arthurpaulhs/Luminocity/Schematics/luci2_device-master/luci2_device_bom.xlsx

No | Component | Unit | Unit Price | Component Price | Reference
1 | AK300/2 | 3 | 0.1 | 0.3 | link (https://www.tokopedia.com/audioparts/terminal-block-2p-2-pin-warna-biru-kf-301)
2 | AK300/4 | 1 | 0.2 | 0.2 | link (https://www.tokopedia.com/audioparts/terminal-block-2p-2-pin-warna-biru-kf-301)
3 | HEADER-1X2ROUND | 1 | 0.3 | 0.3 | link (https://www.tokopedia.com/goldendream/pin-header-254mm-male-40-pin-single-row-strip-silver-connector)
4 | HEADER-1X3ROUND
5 | HEADER-1X5ROUND
6 | TAC_SWITCHPTH | 1 | 0.1 | 0.1 | link (https://www.tokopedia.com/goldendream/tact-switch-6x6x43mm-saklar-kecil-micro-on-off-tactile-4-pin)
7 | 1N4004 | 1 | 0.1 | 0.1 | link (https://www.tokopedia.com/pielectronics/1n4004-rectifier-diode-dioda-m4-1a-400v)
8 | 2N3904-MMBT | 1 | 0.1 | 0.1 | link (http://www.aliexpress.com/item/100PCS-MMBT3904-SOT-23-2N3904-SMD-40V-200mA-NPN-Transistor/1852107626.html)
9 | ARDUINO_PRO_MICRO | 1 | 3.4 | 3.4 | link (http://www.aliexpress.com/item/Free-Shipping-5-pcs-Mini-Leonardo-Pro-Micro-ATmega32U4-5V-16MHz-Module-For-Arduino-Best-Quality/32269794147.html)
10 | LEDCHIPLED_0805 | 1 | 0.1 | 0.1 | JP
11 | DCDCMODULE_SMALL | 2 | 1.2 | 2.4 | link (https://www.tokopedia.com/goldendream/mini-lm2596-adjustable-dc-dc-step-down-module-in-45-28v-out-08-20v)
12 | ESP07-16PIN | 1 | 2.5 | 2.5 | link (http://www.aliexpress.com/item/ESP8266-serial-WIFI-model-ESP-07-Authenticity-Guaranteed/32220241193.html)
13 | HLK-PM01 | 1 | 4 | 4 | link (http://www.hlktech.net/product_detail.php?ProId=56)
14 | PMOSFET_PTO220BV | 1 | 1 | 1 | link (https://www.tokopedia.com/akhishop/irf-9540)
15 | R-EU_M0805 | 1 | 1 | 1 | JP
16 | R-EU_M0805
17 | R-EU_M0805
18 | R-EU_M0805
19 | R-EU_M0805
20 | LEDCHIPLED_0805 | 1 | 0.1 | 0.1 | JP
21 | XBEE-PRO | 1 | 17.5 | 17.5 | link (http://www.digikey.com/product-detail/en/XB24CZ7SIT-004/602-1558-ND/5322372?WT.z_cid=ref_neda_dkc_buynow)
22 | XBEE-HEADER | 2 | 0.5 | 1 | link (https://www.tokopedia.com/sadewa-elc/female-header-2mm-20mm-1x40-socket-xbee)
23 | XBEE-ANTENNA | 1 | 2.5 | 2.5 | link (http://www.aliexpress.com/item/5-piece-lot-2-4-GHz-5dBi-802-11b-g-WiFi-Antenna-Aerial-RP-SMA-Male/32602509915.html)
24 | WIFI-ANTENNA | 1 | 1.1 | 1.1 | link (http://www.aliexpress.com/item/Hot-Sale-Smart-Electronics-1set-ESP-8266-ESP8266-Serial-WIFI-Wireless-Transceiver-Module-MT7681-3DBI-Gain/32443768782.html)
25 | ARDUINO-HEADER | 1 | 0.5 | 0.5 | JP
Jumlah |  |  |  | 38.2
Smallest unit price is USD 0,1
Currency in USD
