arthurpaulhs/Luminocity/Schematics/luci2_device-master/luci2_device_revA.brd

## EAGLE design Schematics/luci2_device-master/luci2_device_revA.brd (2016-07-13, an earlier design)

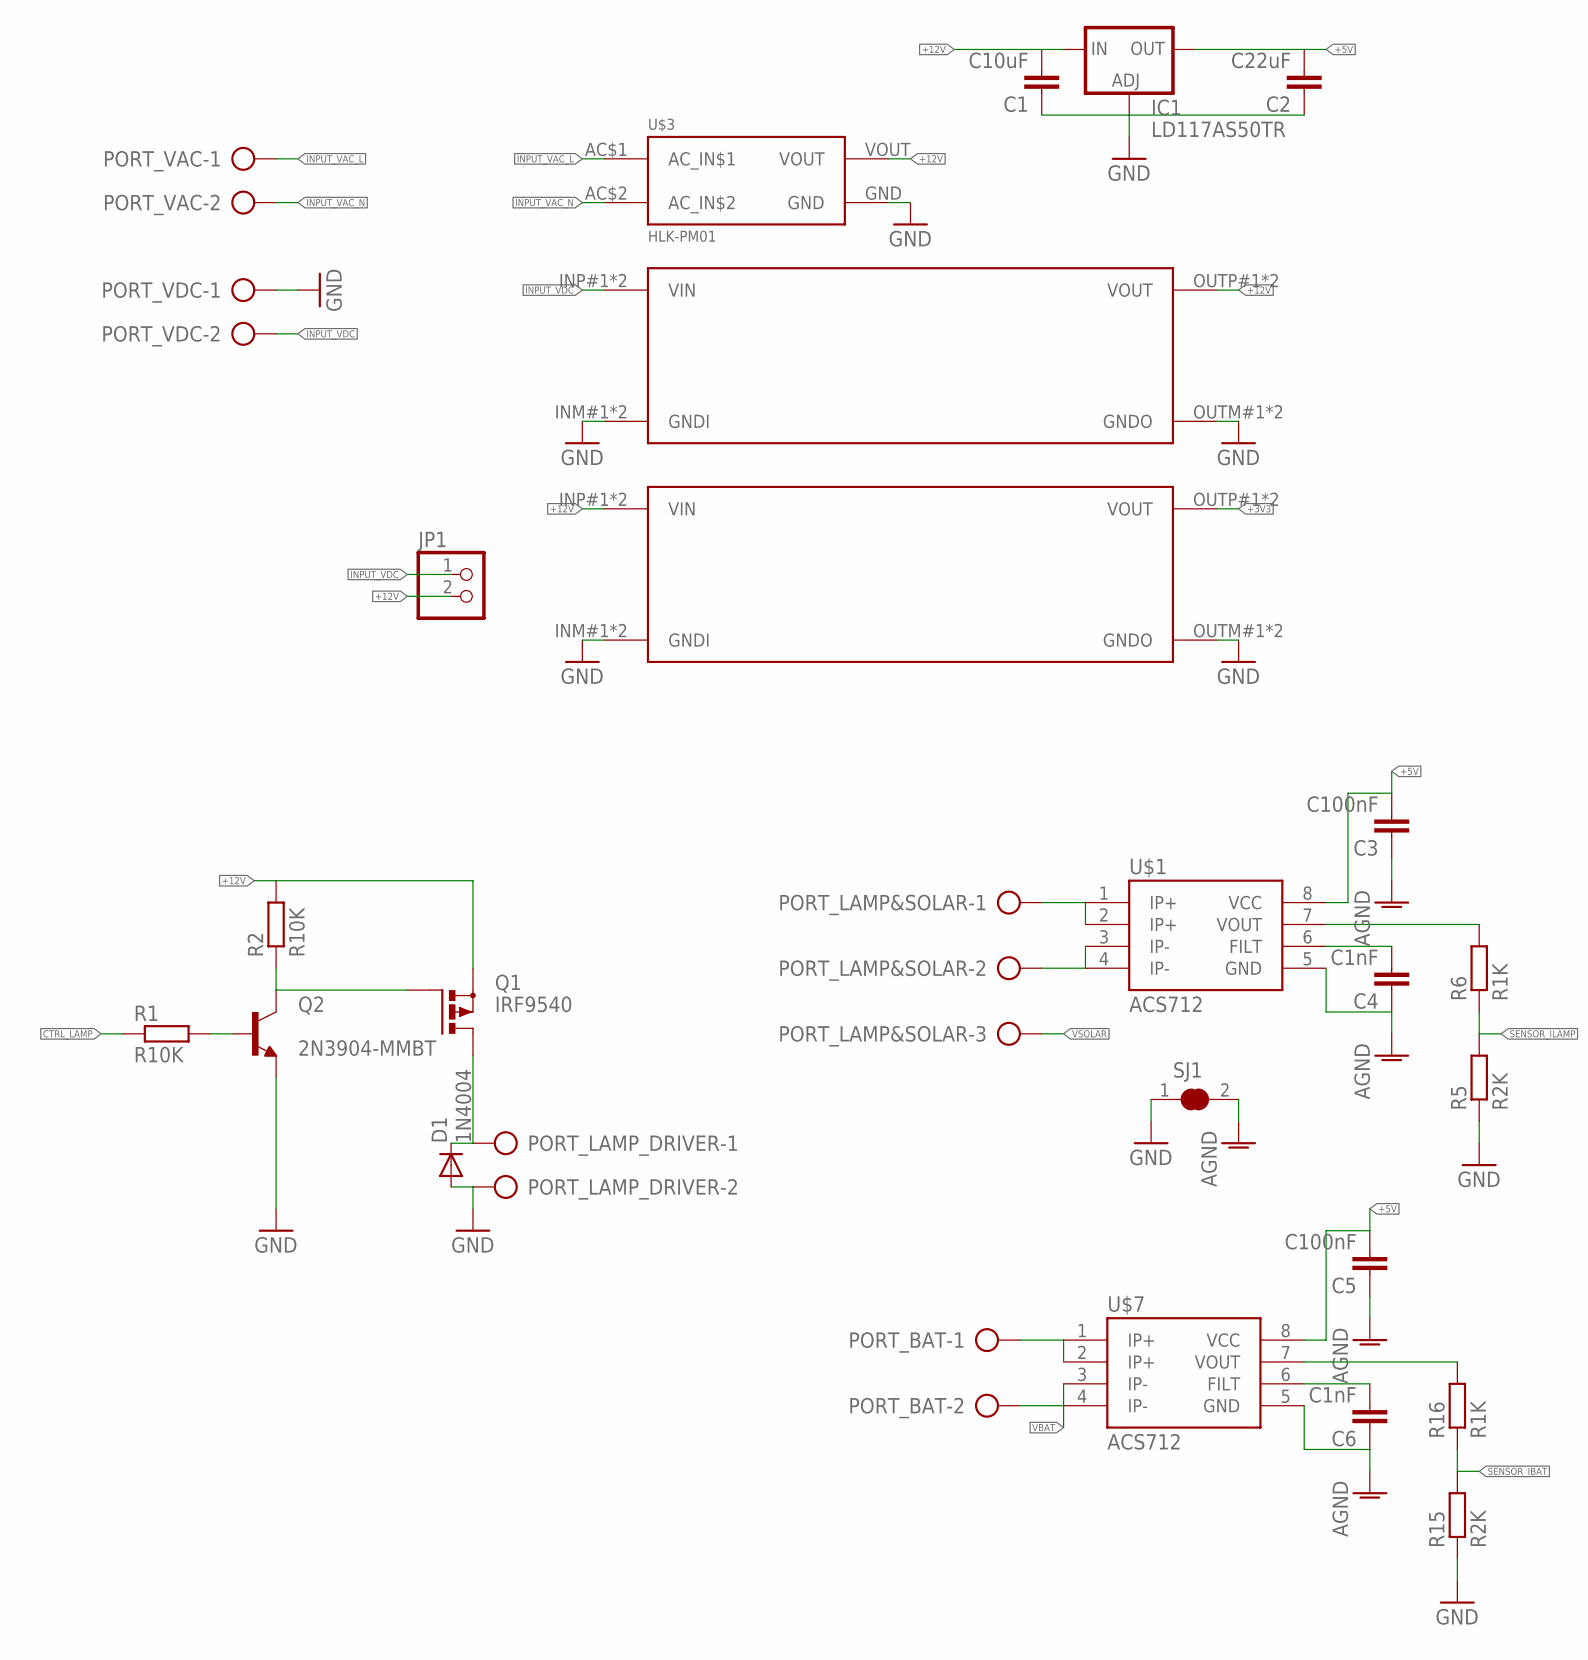
[picture p1: schematic luci2_device_revA.sch, part in row 1, column 1]

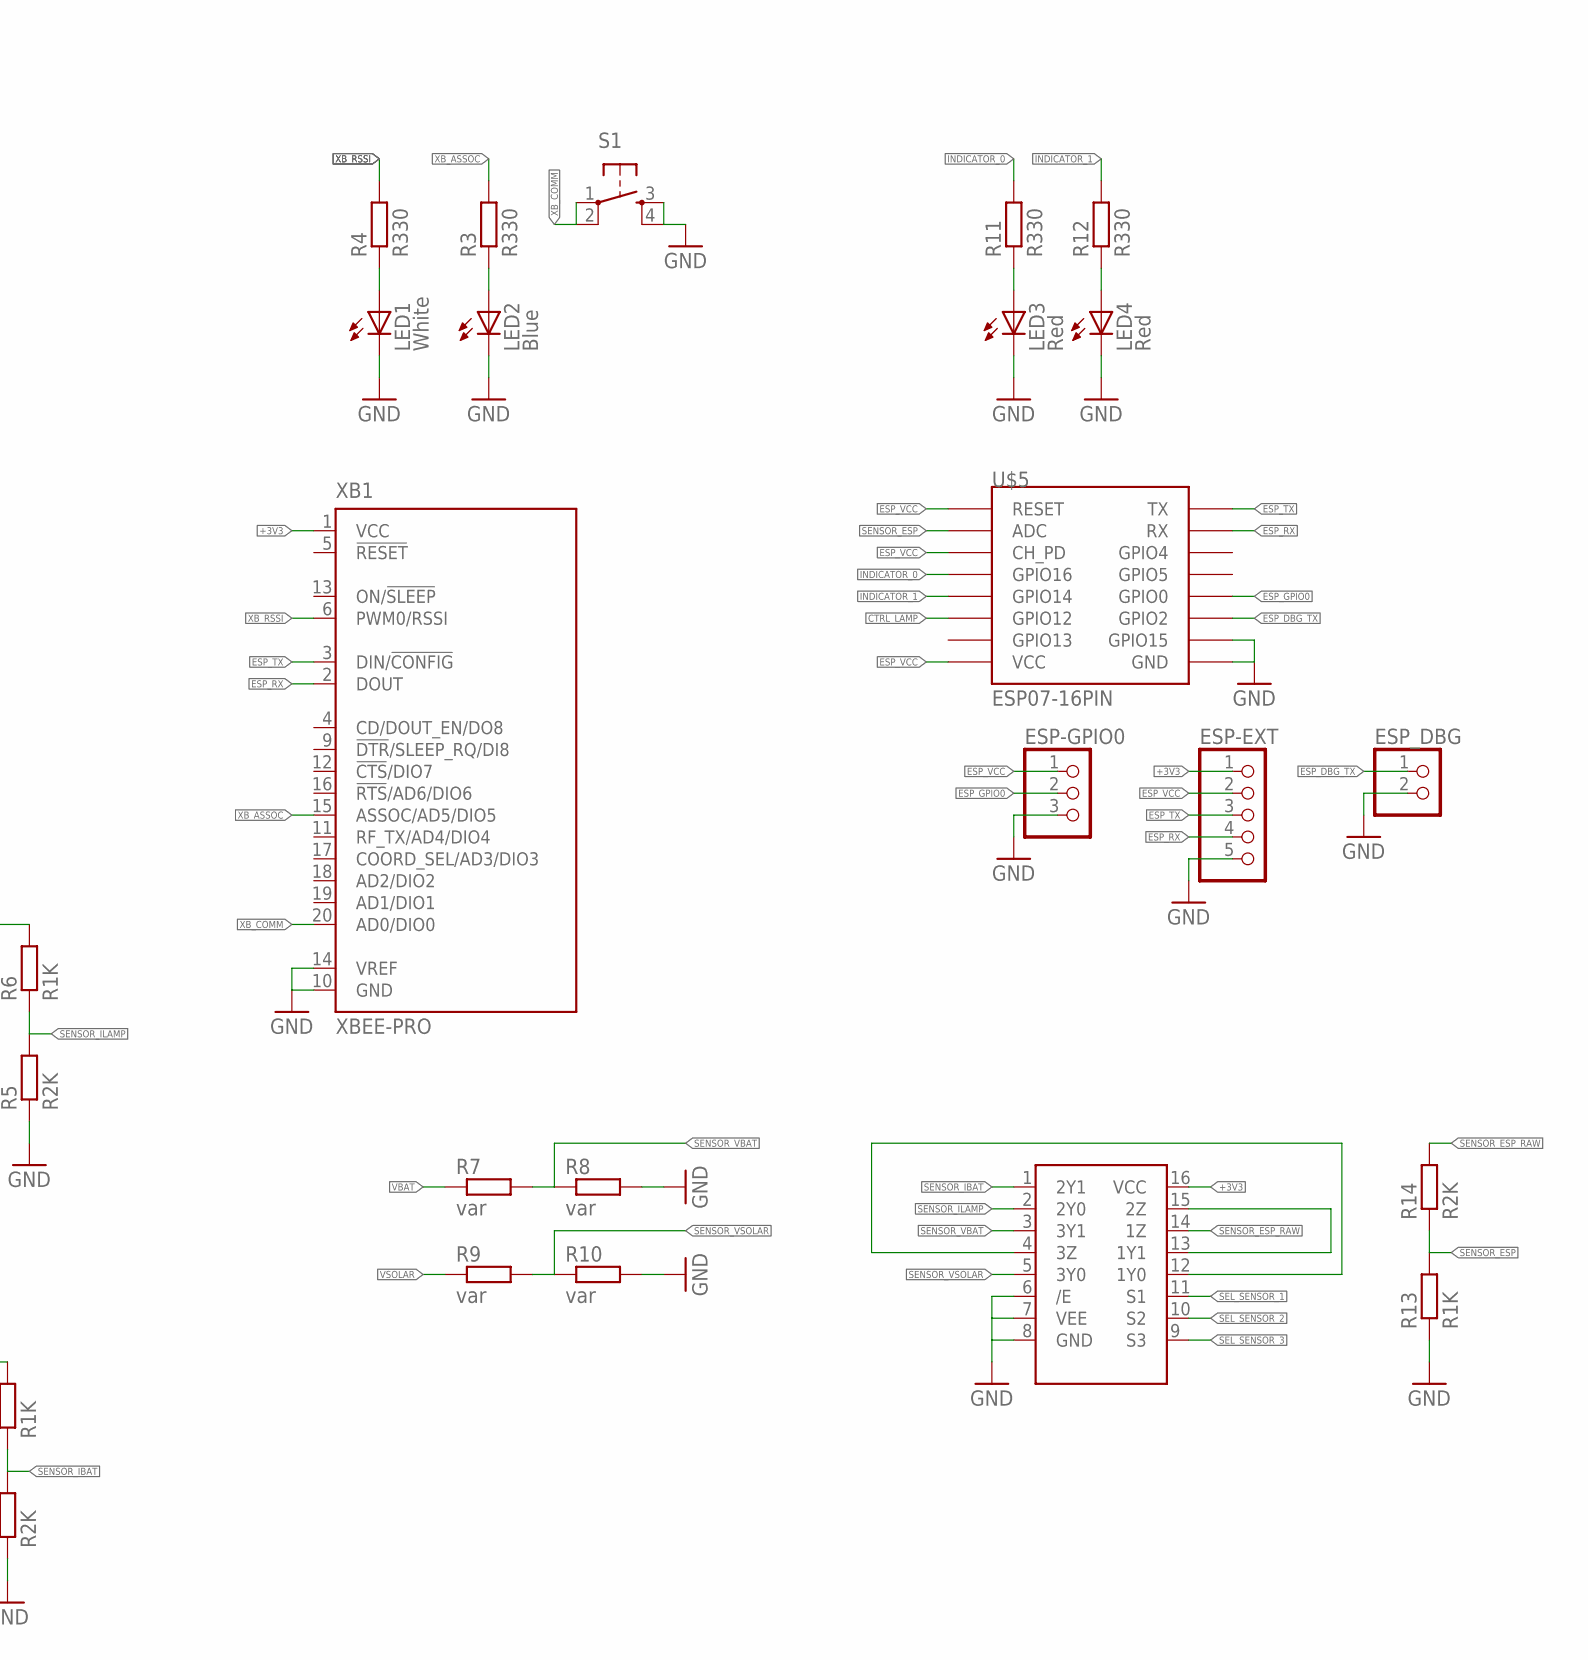
[picture p2: schematic luci2_device_revA.sch, part in row 1, column 2]

Parts:
C1: C10uF; C0805
C2: C22uF; C0805
C3, C5: C100nF; C0805
C4, C6: C1nF; C0805
D1: 1N4004; DO41-10
ESP-EXT: HEADER-1X5ROUND; 1X05_ROUND
ESP-GPIO0: HEADER-1X3ROUND; 1X03_ROUND
ESP_DBG: HEADER-1X2ROUND; 1X02_ROUND
IC1: LD117AS50TR; SOT223
JP1: HEADER-1X2ROUND; 1X02_ROUND
LED1: White; CHIPLED_0805
LED2: Blue; CHIPLED_0805
LED3, LED4: Red; CHIPLED_0805
PORT_BAT: AK300/2
PORT_LAMP&SOLAR: AK300/3
PORT_LAMP_DRIVER: AK300/2
PORT_VAC: AK300/2
PORT_VDC: AK300/2
Q1: IRF9540; TO220BV
Q2: 2N3904-MMBT; SOT23
R1, R2: R10K; M0805
R3, R4, R11, R12: R330; M0805
R5, R14, R15: R2K; M0805
R6, R13, R16: R1K; M0805
R7, R8, R9, R10: var; M0805
S1: TAC_SWITCHPTH; TACTILE-PTH
SJ1: SOLDERJUMPER_CLOSED; SOLDERJUMPER_CLOSEDWIRE
U$1, U$7: ACS712; SO08
U$2, U$4: DCDCMODULE_SMALL; DCDCMODULE-SMALL
U$3: HLK-PM01
U$5: ESP07-16PIN
U$6: 74HC4053D; SO16
XB1: XBEE-PRO

Connections:
+3V3: ESP-EXT.1, U$2.OUTP#1 (VOUT), U$2.OUTP#2 (VOUT), U$6.16 (VCC), XB1.1 (VCC)
+5V: C2.2, C3.2, C5.2, IC1.4 (OUT), U$1.8 (VCC), U$7.8 (VCC)
+12V: C1.2, IC1.3 (IN), JP1.2, Q1.S, R2.2, U$2.INP#1 (VIN), U$2.INP#2 (VIN), U$3.VOUT, U$4.OUTP#1 (VOUT), U$4.OUTP#2 (VOUT)
AGND: C3.1, C4.1, C5.1, C6.1, SJ1.2, U$1.5 (GND), U$7.5 (GND)
CTRL_LAMP: R1.1, U$5.GPIO12
ESP_DBG_TX: ESP_DBG.1, U$5.GPIO2
ESP_GPIO0: ESP-GPIO0.2, U$5.GPIO0
ESP_RX: ESP-EXT.4, U$5.RX, XB1.2 (DOUT)
ESP_TX: ESP-EXT.3, U$5.TX, XB1.3 (DIN/!CONFIG)
ESP_VCC: ESP-EXT.2, ESP-GPIO0.1, U$5.CH_PD, U$5.REST (RESET), U$5.VCC
GND: C1.1, C2.1, D1.A, ESP-EXT.5, ESP-GPIO0.3, ESP_DBG.2, IC1.1 (ADJ), LED1.C, LED2.C, LED3.C, LED4.C, PORT_LAMP_DRIVER.2, PORT_VDC.1, Q2.2 (E), R5.1, R8.2, R10.2, R13.1, R15.1, S1.3, S1.4, SJ1.1, U$2.INM#1 (GNDI), U$2.INM#2 (GNDI), U$2.OUTM#1 (GNDO), U$2.OUTM#2 (GNDO), U$3.GND, U$4.INM#1 (GNDI), U$4.INM#2 (GNDI), U$4.OUTM#1 (GNDO), U$4.OUTM#2 (GNDO), U$5.GND, U$5.GPIO15, U$6.6 (/E), U$6.7 (VEE), U$6.8 (GND), XB1.10 (GND), XB1.14 (VREF)
INDICATOR_0: R11.2, U$5.GPIO16
INDICATOR_1: R12.2, U$5.GPIO14
INPUT_VAC_L: PORT_VAC.1, U$3.AC$1 (AC_IN$1)
INPUT_VAC_N: PORT_VAC.2, U$3.AC$2 (AC_IN$2)
INPUT_VDC: JP1.1, PORT_VDC.2, U$4.INP#1 (VIN), U$4.INP#2 (VIN)
unnamed: D1.C, PORT_LAMP_DRIVER.1, Q1.D
unnamed: Q1.G, Q2.3 (C), R2.1
unnamed: LED1.A, R4.1
unnamed: Q2.1 (B), R1.2
unnamed: LED2.A, R3.1
unnamed: U$6.13 (1Y1), U$6.15 (2Z)
unnamed: R6.2, U$1.7 (VOUT)
unnamed: PORT_LAMP&SOLAR.1, U$1.1 (IP+), U$1.2 (IP+)
unnamed: U$6.4 (3Z), U$6.12 (1Y0)
unnamed: PORT_LAMP&SOLAR.2, U$1.3 (IP-), U$1.4 (IP-)
unnamed: C4.2, U$1.6 (FILT)
unnamed: PORT_BAT.1, U$7.1 (IP+), U$7.2 (IP+)
unnamed: C6.2, U$7.6 (FILT)
unnamed: R16.2, U$7.7 (VOUT)
unnamed: LED3.A, R11.1
unnamed: LED4.A, R12.1
SEL_SENSOR_1: U$6.11 (S1)
SEL_SENSOR_2: U$6.10 (S2)
SEL_SENSOR_3: U$6.9 (S3)
SENSOR_ESP: R13.2, R14.1, U$5.ADC
SENSOR_ESP_RAW: R14.2, U$6.14 (1Z)
SENSOR_IBAT: R15.2, R16.1, U$6.1 (2Y1)
SENSOR_ILAMP: R5.2, R6.1, U$6.2 (2Y0)
SENSOR_VBAT: R7.2, R8.1, U$6.3 (3Y1)
SENSOR_VSOLAR: R9.2, R10.1, U$6.5 (3Y0)
VBAT: PORT_BAT.2, R7.1, U$7.3 (IP-), U$7.4 (IP-)
VSOLAR: PORT_LAMP&SOLAR.3, R9.1
XB_ASSOC: R3.2, XB1.15 (ASSOC/AD5/DIO5)
XB_COMM: S1.1, S1.2, XB1.20 (AD0/DIO0)
XB_RSSI: R4.2, XB1.6 (PWM0/RSSI)

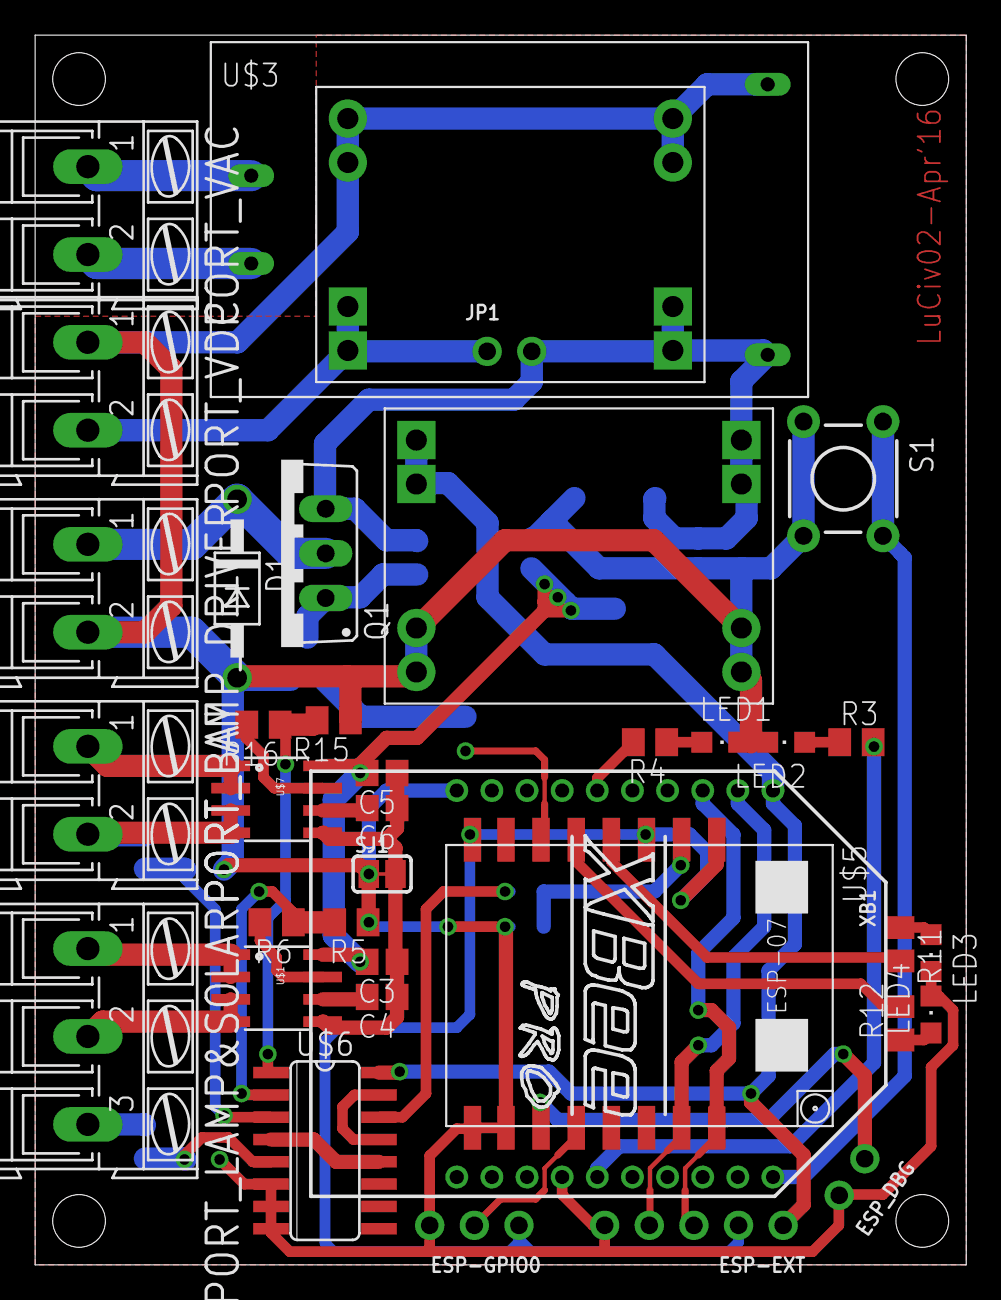
[picture p3: board luci2_device_revA.brd from above]

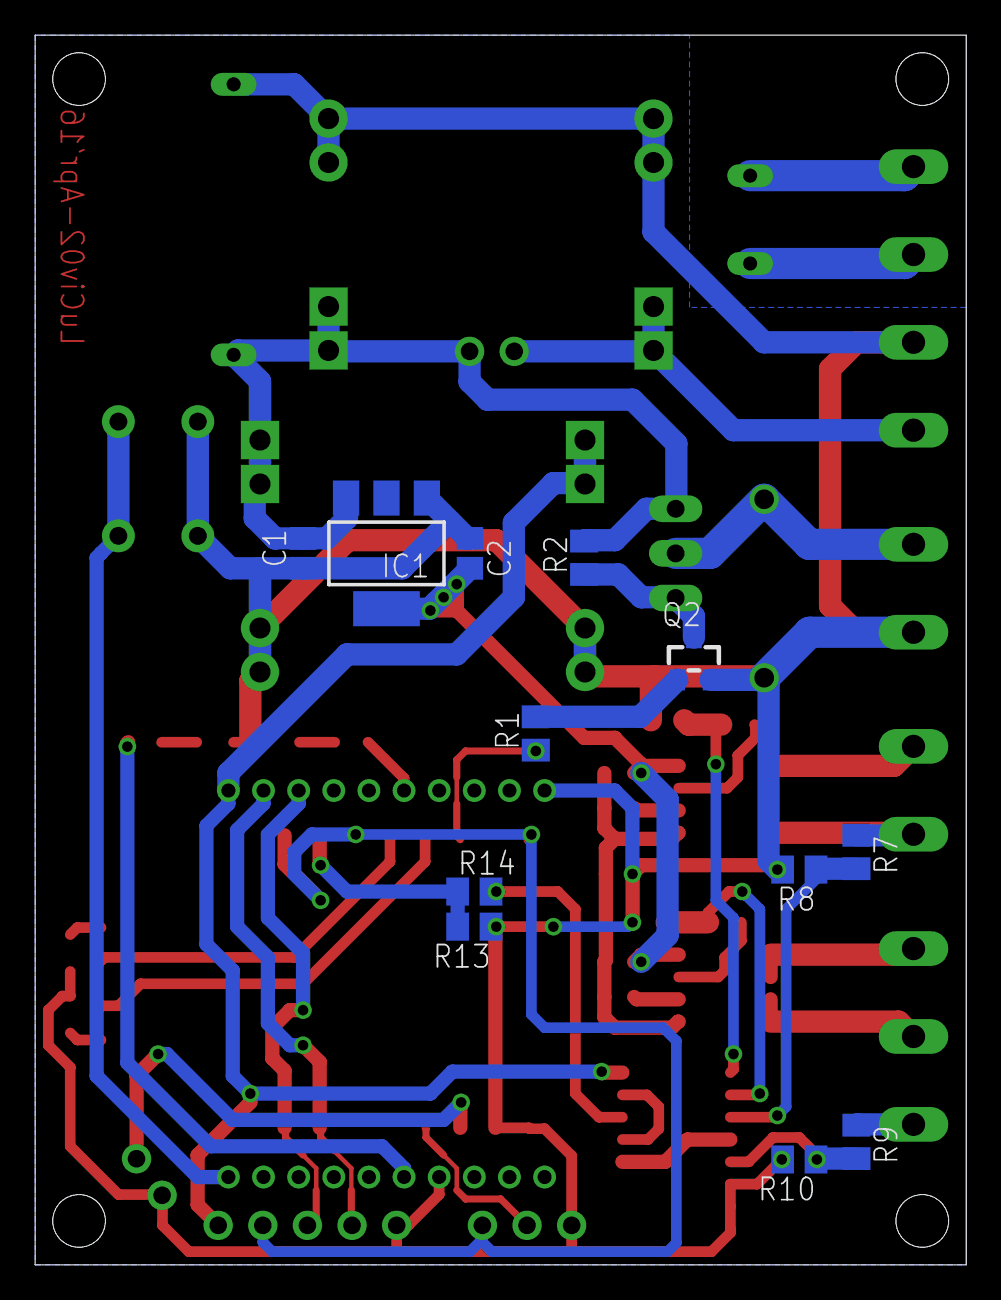
[picture p4: board luci2_device_revA.brd from below]

Board: 2 copper layers, 53.0 x 70.0 mm, 49 parts (12 on the bottom side), 43 nets.
