arthurpaulhs/Luminocity/Schematics/luci2_device-master/luci2_device.brd

## EAGLE design Schematics/luci2_device-master/luci2_device.brd (2016-07-13)

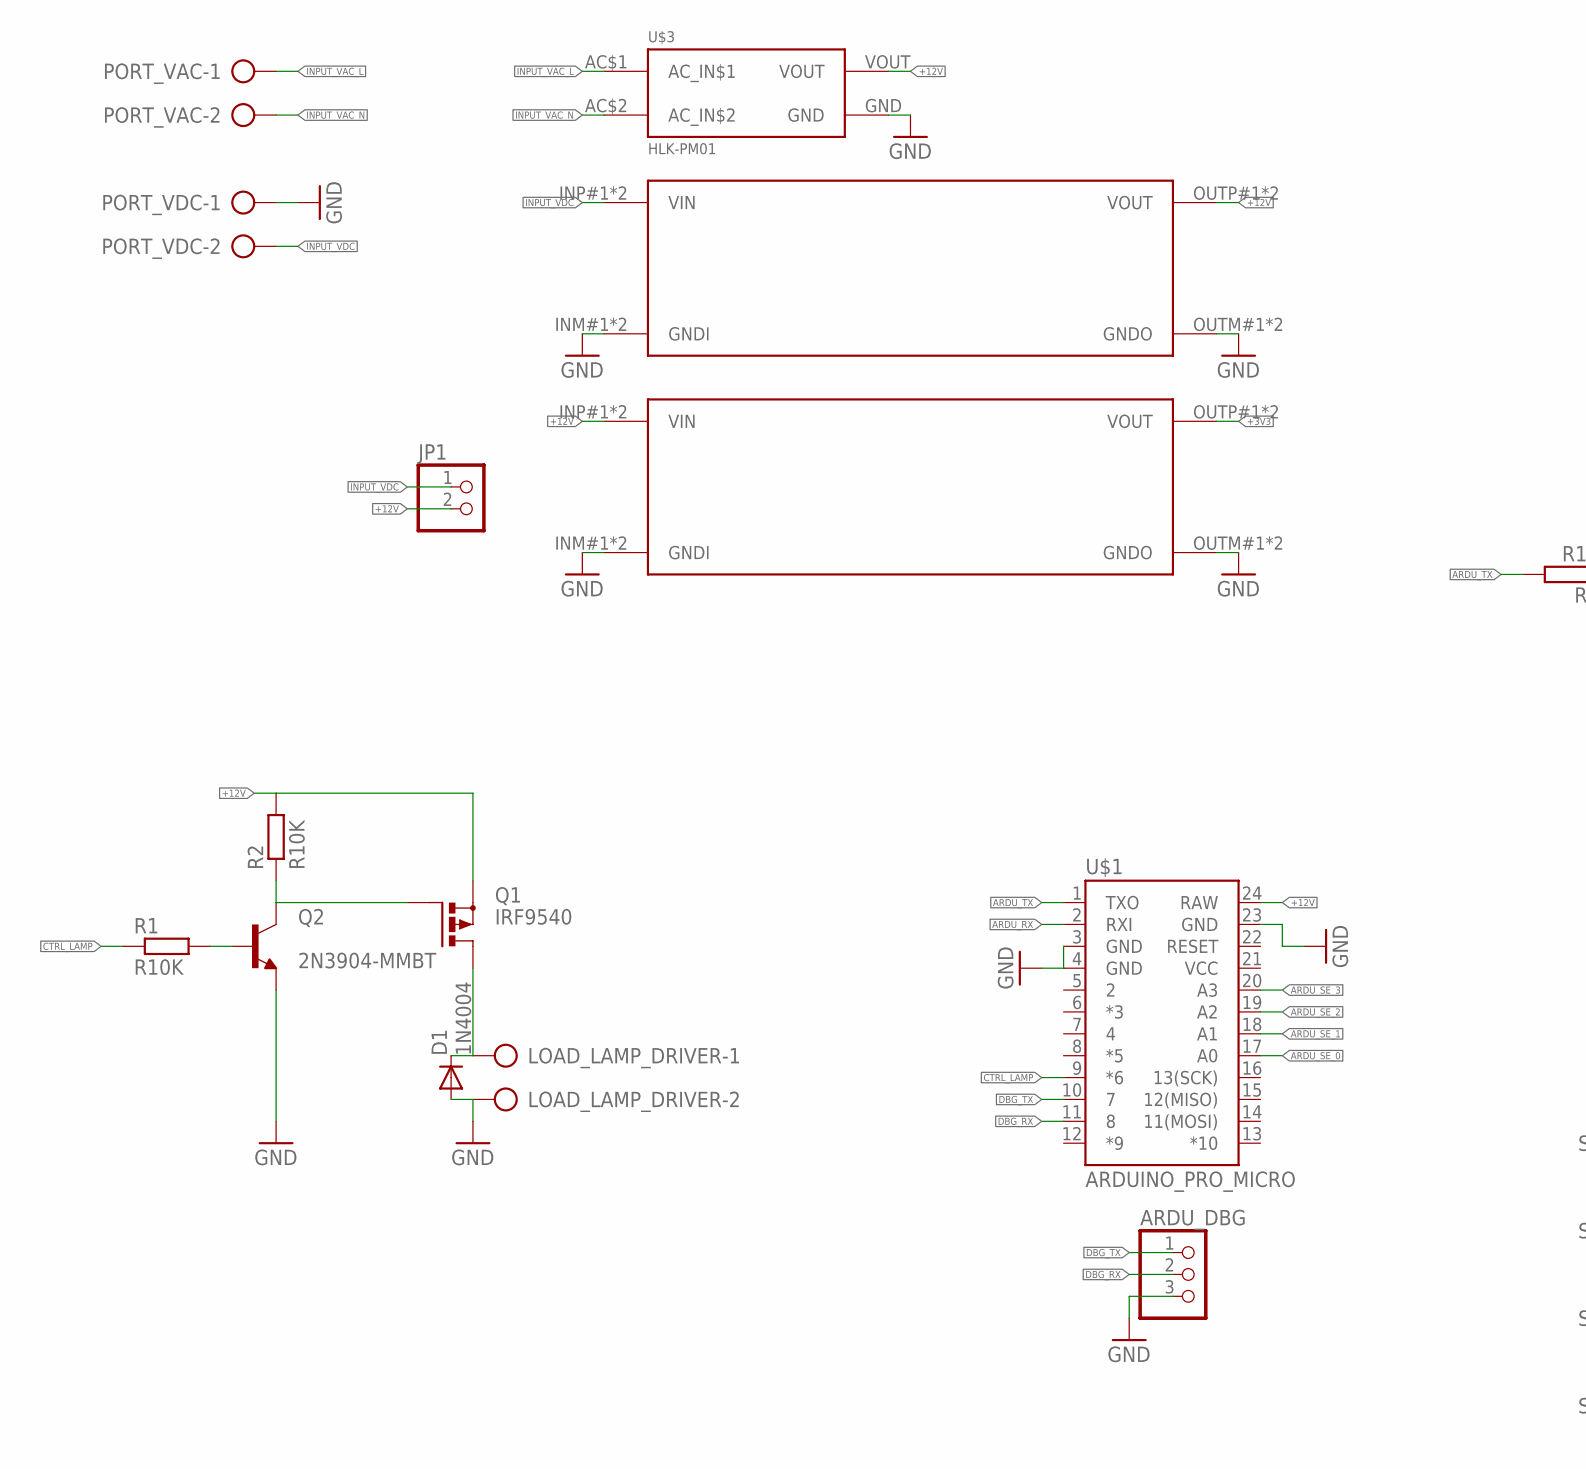
[picture p5: schematic luci2_device.sch, part in row 1, column 1]

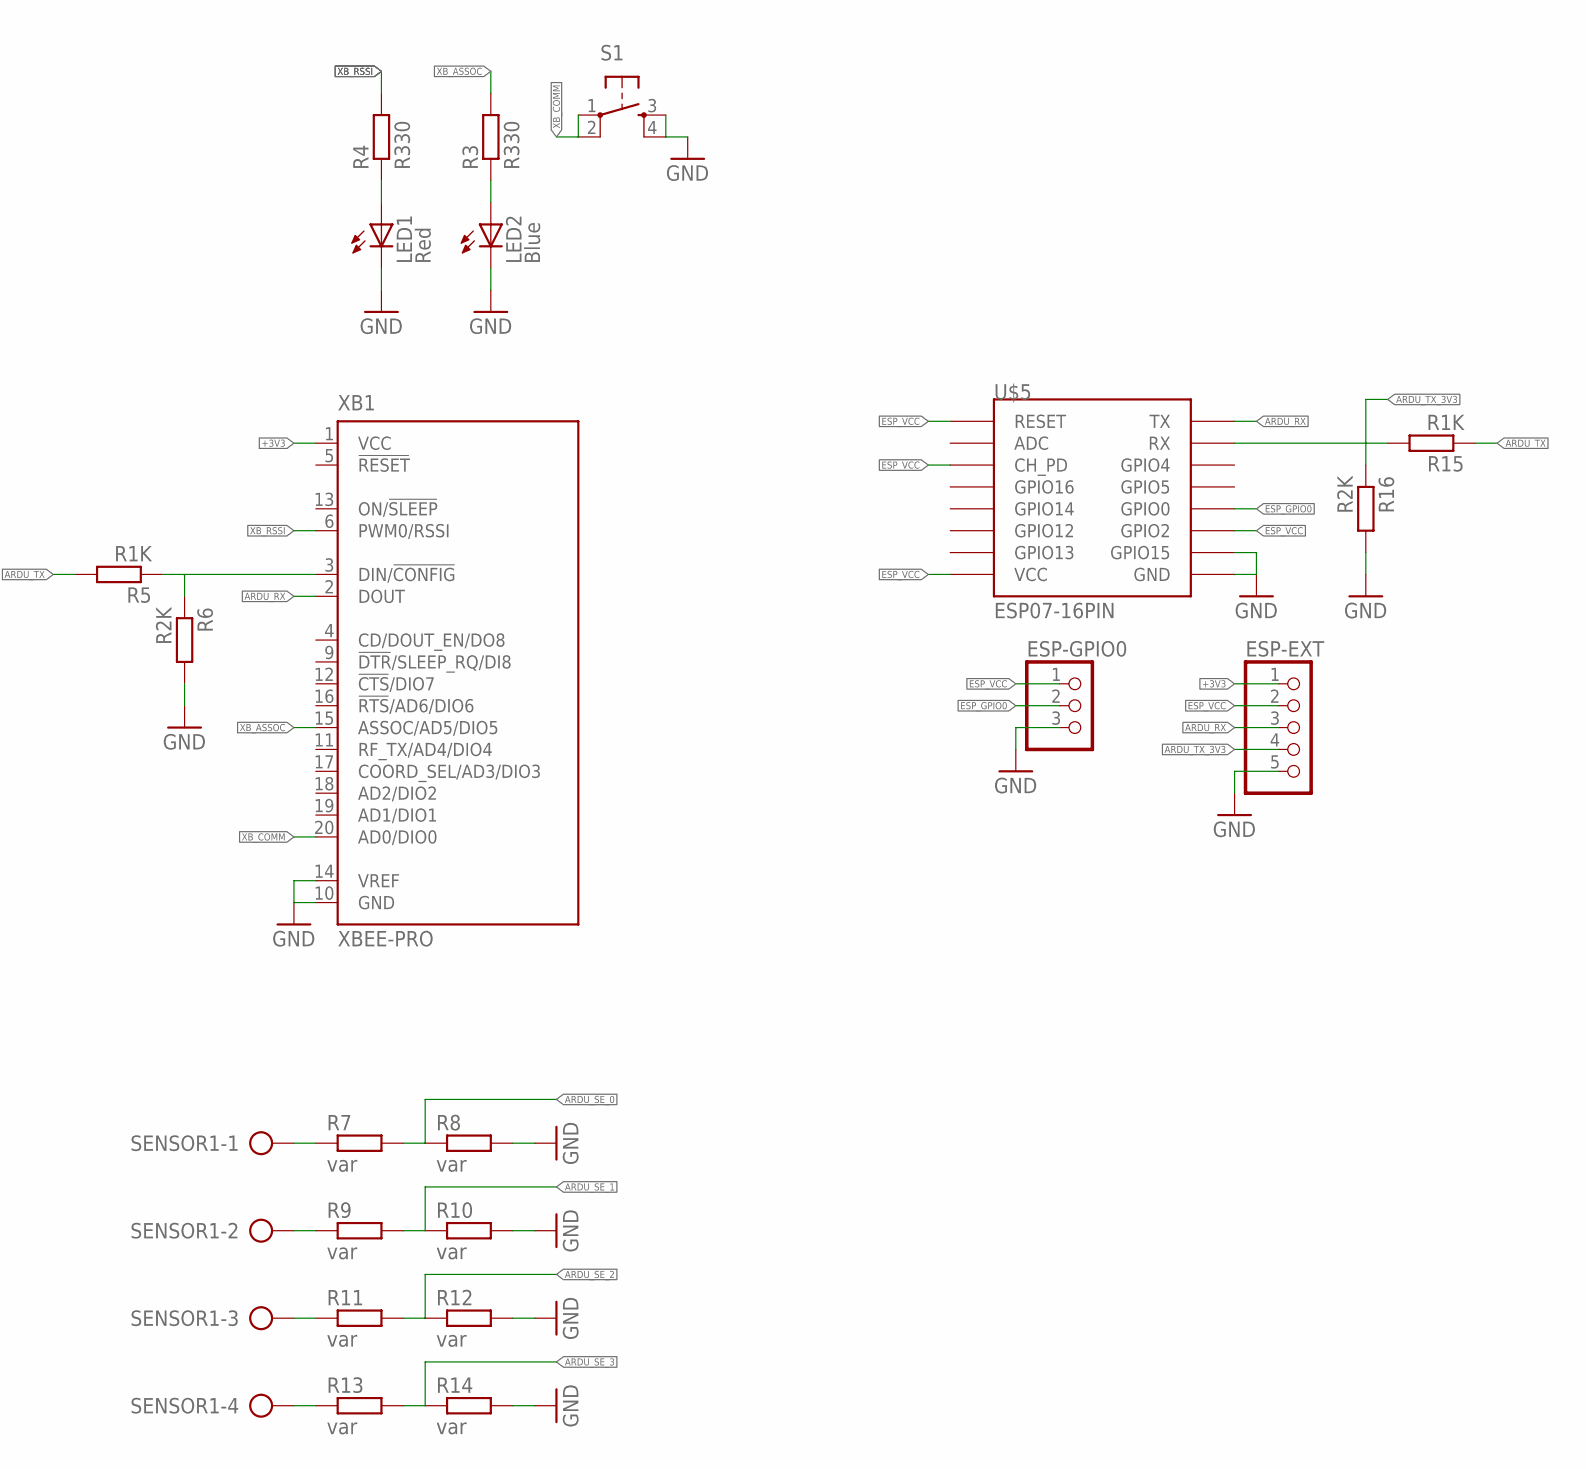
[picture p6: schematic luci2_device.sch, part in row 1, column 2]

Parts:
ARDU_DBG: HEADER-1X3ROUND; 1X03_ROUND
D1: 1N4004; DO41-10
ESP-EXT: HEADER-1X5ROUND; 1X05_ROUND
ESP-GPIO0: HEADER-1X3ROUND; 1X03_ROUND
JP1: HEADER-1X2ROUND; 1X02_ROUND
LED1: Red; CHIPLED_0805
LED2: Blue; CHIPLED_0805
LOAD_LAMP_DRIVER: AK300/2
PORT_VAC: AK300/2
PORT_VDC: AK300/2
Q1: IRF9540; TO220BV
Q2: 2N3904-MMBT; SOT23
R1, R2: R10K; M0805
R3, R4: R330; M0805
R5, R15: R1K; M0805
R6, R16: R2K; M0805
R7, R8, R9, R10, R11, R12, R13, R14: var; M0805
S1: TAC_SWITCHPTH; TACTILE-PTH
SENSOR1: AK300/4
U$1: ARDUINO_PRO_MICRO
U$2, U$4: DCDCMODULE_SMALL; DCDCMODULE-SMALL
U$3: HLK-PM01
U$5: ESP07-16PIN
XB1: XBEE-PRO

Connections:
+3V3: ESP-EXT.1, U$2.OUTP#1 (VOUT), U$2.OUTP#2 (VOUT), XB1.1 (VCC)
+12V: JP1.2, Q1.S, R2.2, U$1.24 (RAW), U$2.INP#1 (VIN), U$2.INP#2 (VIN), U$3.VOUT, U$4.OUTP#1 (VOUT), U$4.OUTP#2 (VOUT)
ARDU_RX: ESP-EXT.3, U$1.2 (RXI), U$5.TX, XB1.2 (DOUT)
ARDU_SE_0: R7.2, R8.1, U$1.17 (A0)
ARDU_SE_1: R9.2, R10.1, U$1.18 (A1)
ARDU_SE_2: R11.2, R12.1, U$1.19 (A2)
ARDU_SE_3: R13.2, R14.1, U$1.20 (A3)
ARDU_TX: R5.2, R15.1, U$1.1 (TXO)
ARDU_TX_3V3: ESP-EXT.4, R15.2, R16.1, U$5.RX
CTRL_LAMP: R1.1, U$1.9 (*6)
DBG_RX: ARDU_DBG.2, U$1.11 (8)
DBG_TX: ARDU_DBG.1, U$1.10 (7)
ESP_GPIO0: ESP-GPIO0.2, U$5.GPIO0
ESP_VCC: ESP-EXT.2, ESP-GPIO0.1, U$5.CH_PD, U$5.GPIO2, U$5.REST (RESET), U$5.VCC
GND: ARDU_DBG.3, D1.A, ESP-EXT.5, ESP-GPIO0.3, LED1.C, LED2.C, LOAD_LAMP_DRIVER.2, PORT_VDC.1, Q2.2 (E), R6.2, R8.2, R10.2, R12.2, R14.2, R16.2, S1.3, S1.4, U$1.3 (GND), U$1.4 (GND), U$1.23 (GND), U$2.INM#1 (GNDI), U$2.INM#2 (GNDI), U$2.OUTM#1 (GNDO), U$2.OUTM#2 (GNDO), U$3.GND, U$4.INM#1 (GNDI), U$4.INM#2 (GNDI), U$4.OUTM#1 (GNDO), U$4.OUTM#2 (GNDO), U$5.GND, U$5.GPIO15, XB1.10 (GND), XB1.14 (VREF)
INPUT_VAC_L: PORT_VAC.1, U$3.AC$1 (AC_IN$1)
INPUT_VAC_N: PORT_VAC.2, U$3.AC$2 (AC_IN$2)
INPUT_VDC: JP1.1, PORT_VDC.2, U$4.INP#1 (VIN), U$4.INP#2 (VIN)
unnamed: D1.C, LOAD_LAMP_DRIVER.1, Q1.D
unnamed: Q1.G, Q2.3 (C), R2.1
unnamed: LED1.A, R4.1
unnamed: Q2.1 (B), R1.2
unnamed: LED2.A, R3.1
unnamed: R5.1, R6.1, XB1.3 (DIN/!CONFIG)
unnamed: R7.1, SENSOR1.1
unnamed: R9.1, SENSOR1.2
unnamed: R11.1, SENSOR1.3
unnamed: R13.1, SENSOR1.4
XB_ASSOC: R3.2, XB1.15 (ASSOC/AD5/DIO5)
XB_COMM: S1.1, S1.2, XB1.20 (AD0/DIO0)
XB_RSSI: R4.2, XB1.6 (PWM0/RSSI)

Board: 2 copper layers, 36 parts (1 on the bottom side), 31 nets, no tracks yet.
