arthurpaulhs/Luminocity/(commit log)

2016-07-13 Initial changes
    Added codes and schematics
    [luci2_device.brd, luci2_device.sch, luci2_device_bom.xlsx, luci2_device_revA.brd, luci2_device_revA.sch, luci2_device_revB.brd, luci2_device_revB.sch]
2016-07-17 Revert "Remove dependencies to WiFi manager library"
    This reverts commit 7ddc9f505449b6533368c53306ebfd8580ca61f2.
    [lucy_control.ino, lucy_measurement.ino]
2016-07-17 Remove dependency to WiFi manager library
    This reverts commit 2e497bd3ec77ac6f69e7d56f12a59148aab5f5cf.
    [lucy_control.ino, lucy_measurement.ino]
2016-07-22 Fix voltage measurement error and esp8266 float publish problem
    [lucy_measurement.ino]
2016-08-08 Fix current measurement error
    [lucy_measurement.ino]
